guilhembn/IOBoard_2021/Readme.md

# IO board Eurobot 2021

## Protobuf

For the fist time you try to build protobuf files, you need to run `setups.sh` in EmbeddedProto:

`cd software/lib/EmbeddedProto`
`./setup.sh`
