guilhembn/IOBoard_2021/statuette/statuette.kicad_pcb

## KiCad design statuette/statuette.kicad_pcb (2022-02-09)

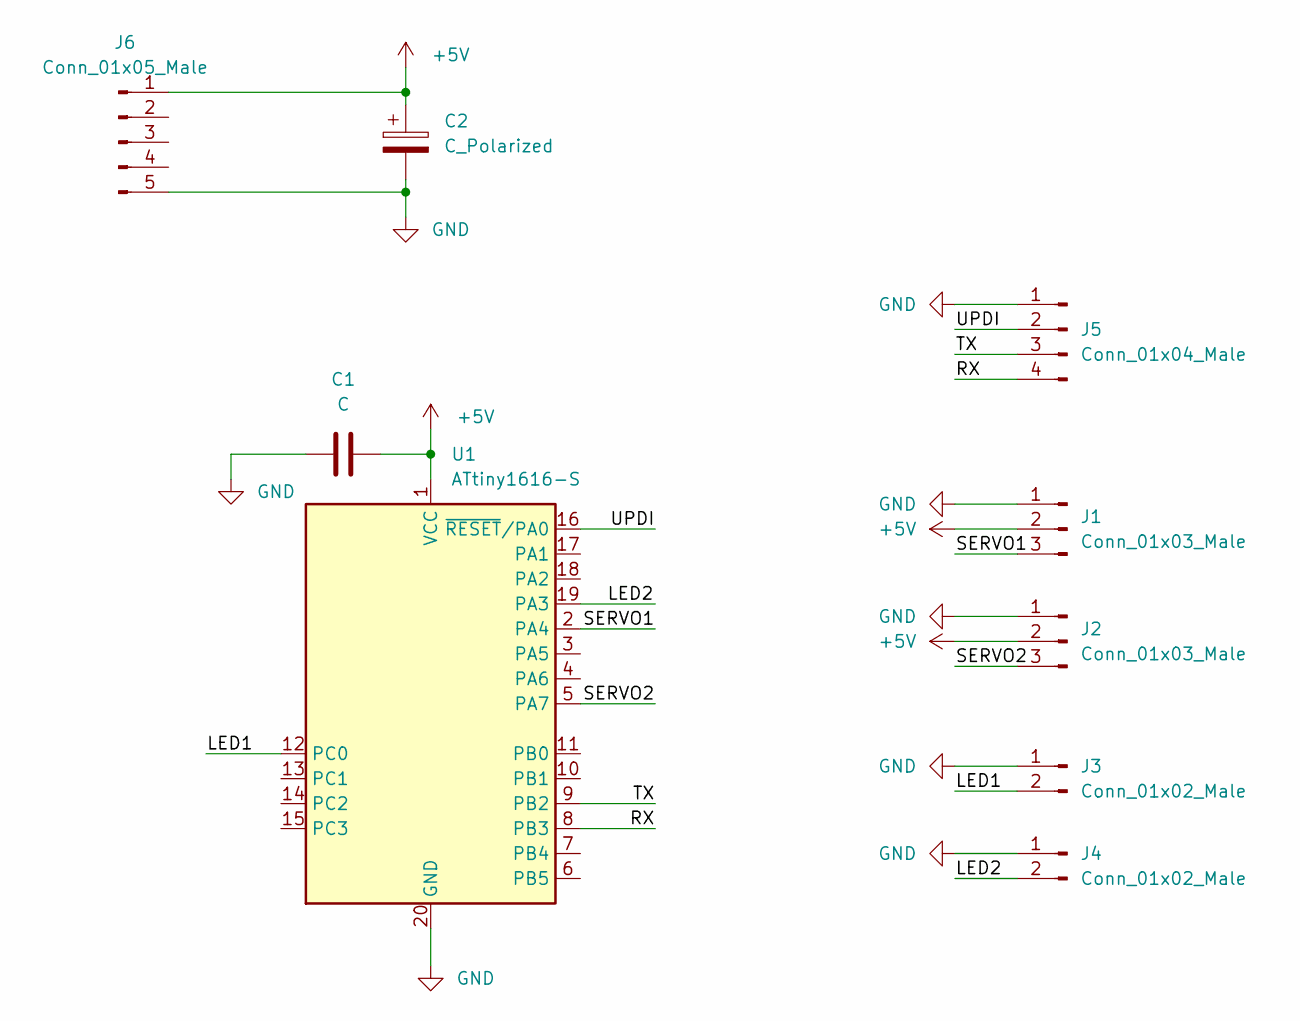
[picture p1: schematic statuette.kicad_sch]

Parts:
C1: C; C_0603_1608Metric_Pad1.08x0.95mm_HandSolder
C2: C_Polarized; CP_EIA-6032-28_Kemet-C_Pad2.25x2.35mm_HandSolder
J1, J2: Conn_01x03_Male; PinHeader_1x03_P2.54mm_Vertical
J3, J4: Conn_01x02_Male; PinHeader_1x02_P2.54mm_Vertical
J5: Conn_01x04_Male; Molex_PicoBlade_53047-0410_1x04_P1.25mm_Vertical
J6: Conn_01x05_Male; PinHeader_1x05_P2.54mm_Vertical
U1: ATtiny1616-S; SOIC-20W_7.5x12.8mm_P1.27mm

Connections:
+5V: C1.2, C2.1, J1.2, J2.2, J6.1, U1.1 (VCC)
/LED1: J3.2, U1.12 (PC0)
/LED2: J4.2, U1.19 (PA3)
/RX: J5.4, U1.8 (PB3)
/SERVO1: J1.3, U1.2 (PA4)
/SERVO2: J2.3, U1.5 (PA7)
/TX: J5.3, U1.9 (PB2)
/UPDI: J5.2, U1.16 (~RESET/PA0)
GND: C1.1, C2.2, J1.1, J2.1, J3.1, J4.1, J5.1, J6.5, U1.20 (GND)

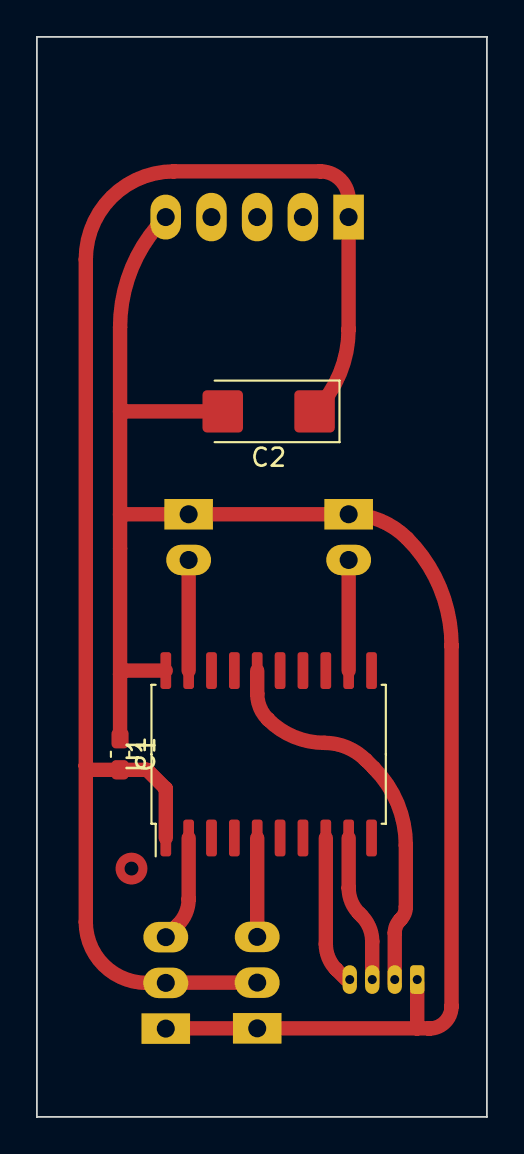
[picture p2: board statuette.kicad_pcb from above]

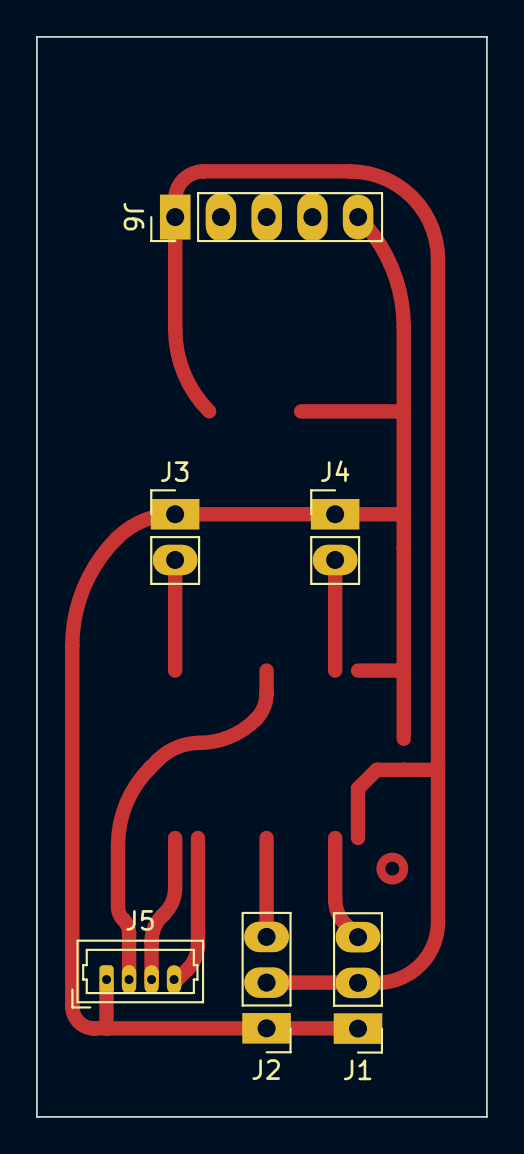
[picture p3: board statuette.kicad_pcb from below]

Board: 2 copper layers, 25.0 x 60.0 mm, 9 parts (6 on the bottom side), 9 nets.
