guilhembn/IOBoard_2021/hardware/IOBoard2021/IOBoard2021.kicad_pcb

## KiCad design hardware/IOBoard2021/IOBoard2021.kicad_pcb (2022-02-09)

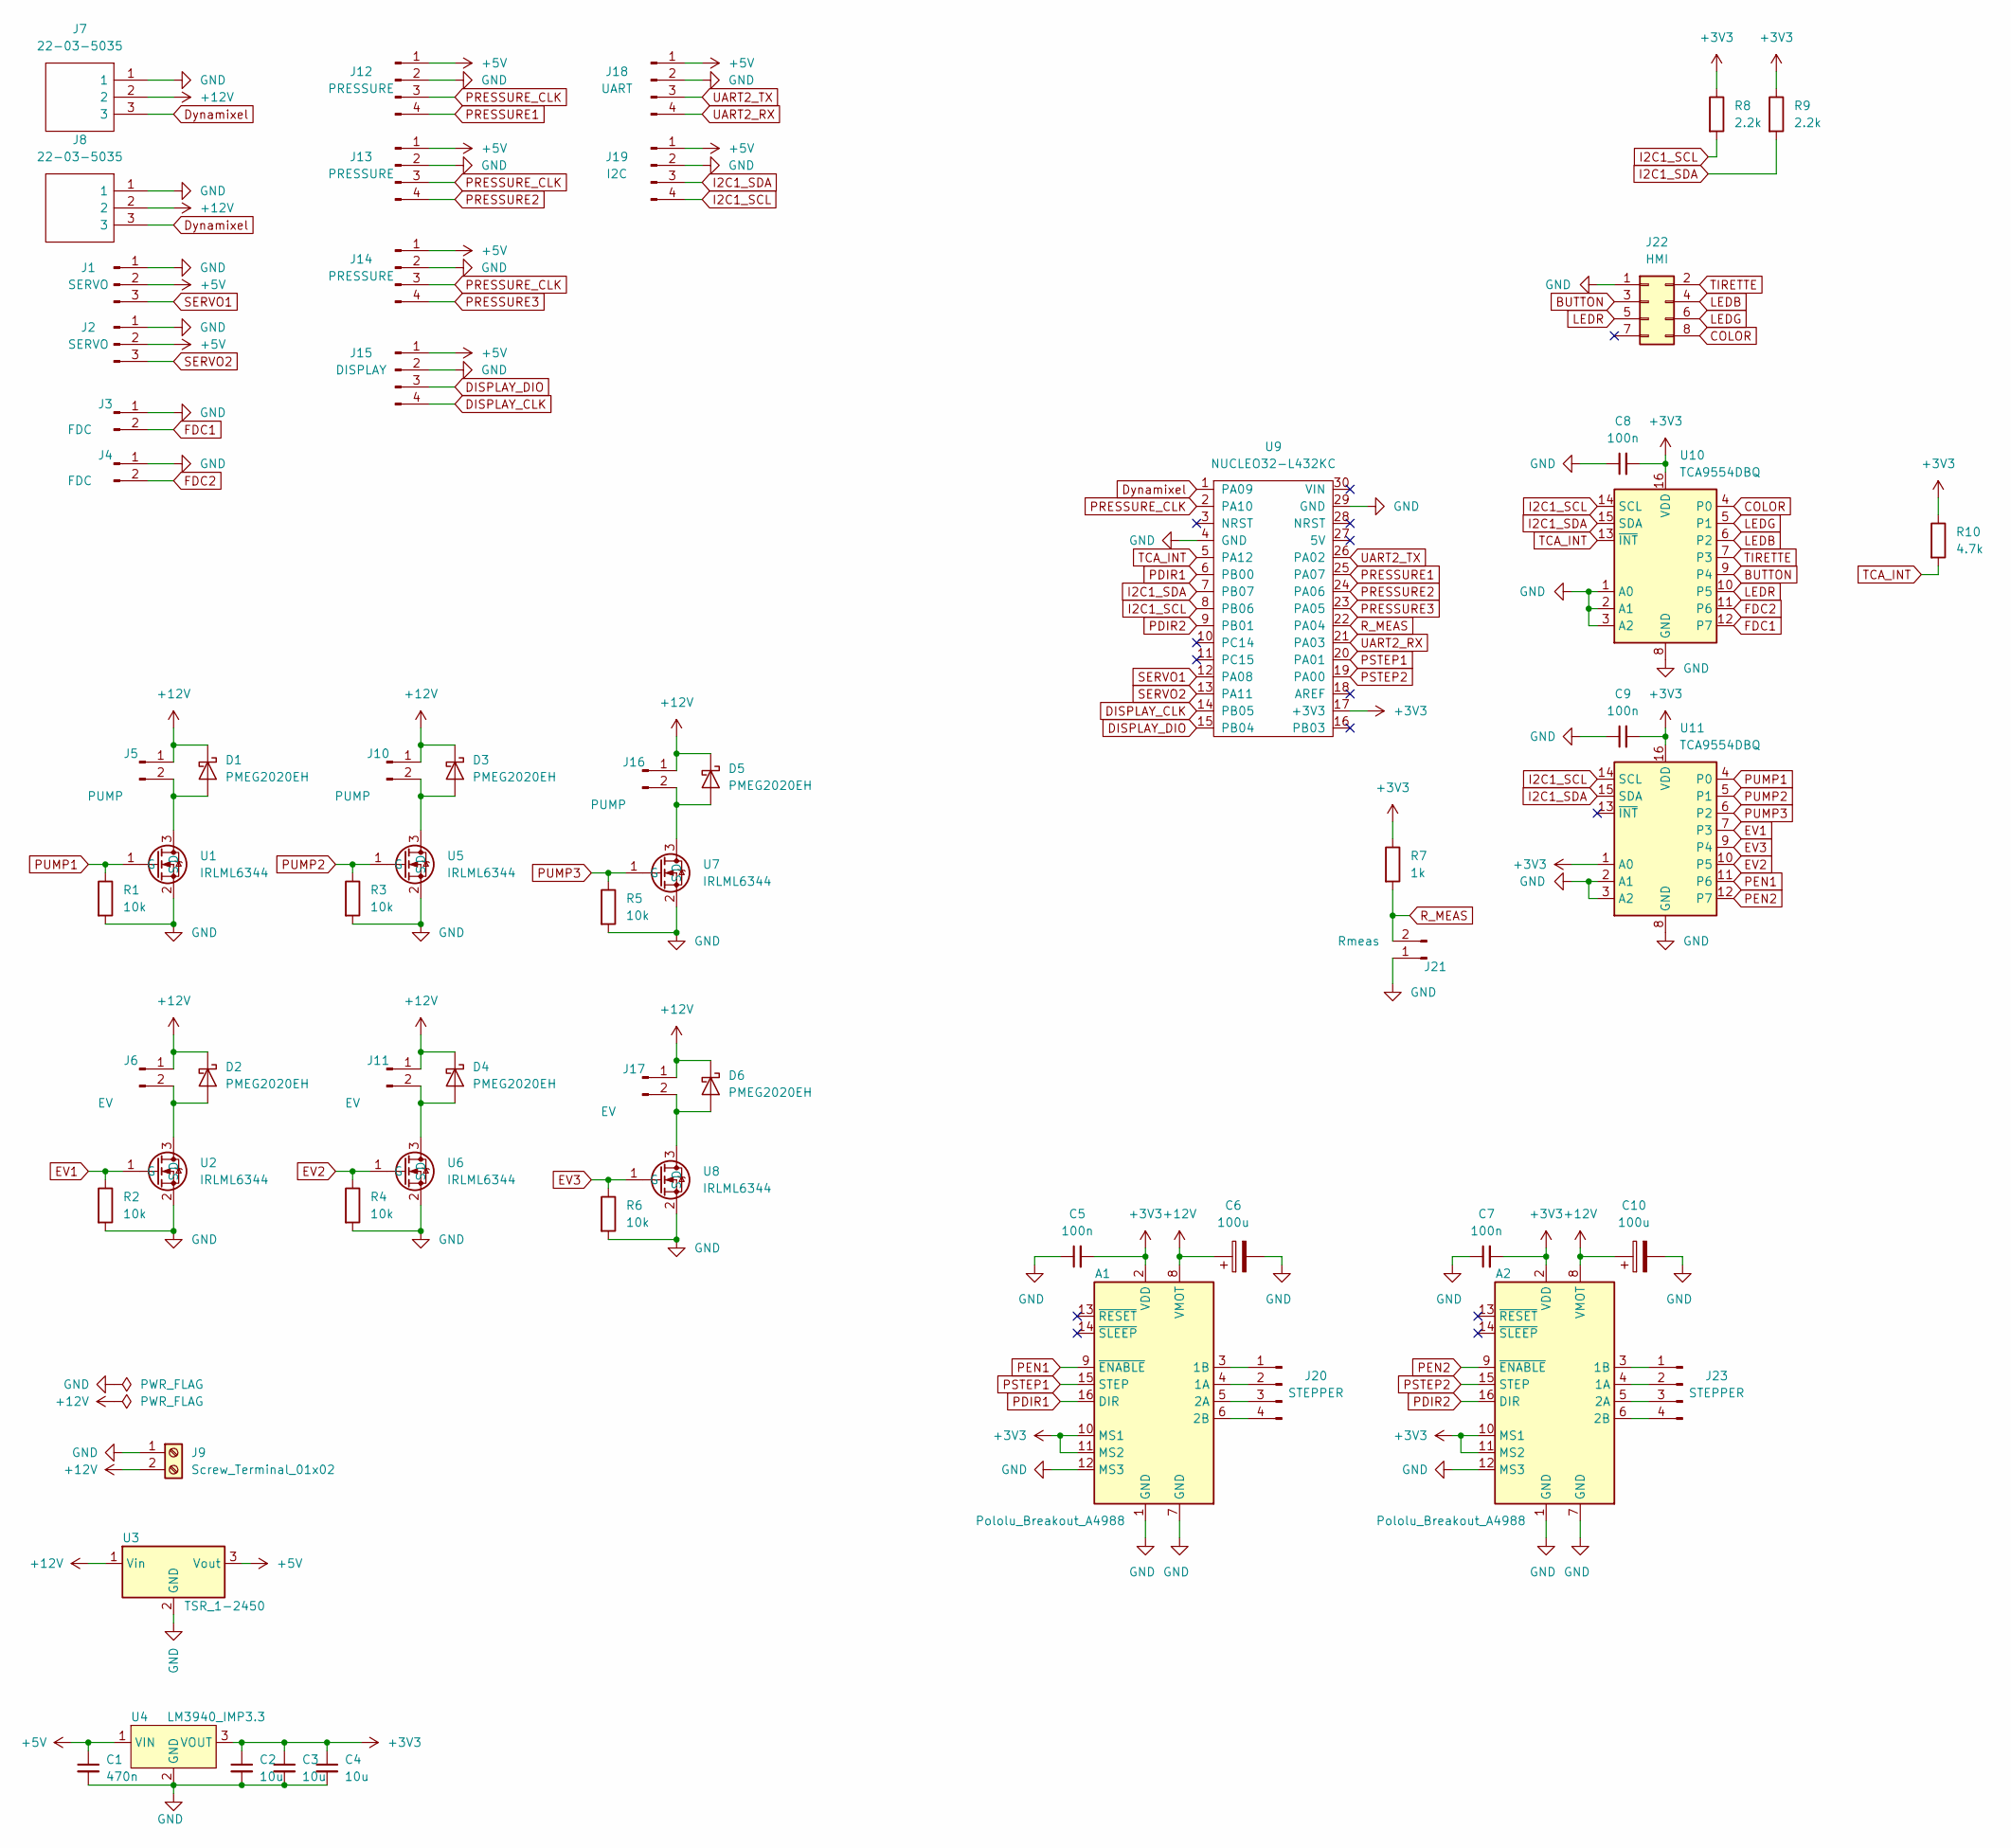
[picture p4: schematic IOBoard2021.kicad_sch, IO board 2022]

Parts:
A1, A2: Pololu_Breakout_A4988; Pololu_Breakout-16_15.2x20.3mm
C1: 470n; C_0603_1608Metric_Pad1.08x0.95mm_HandSolder
C2, C3, C4: 10u; C_0603_1608Metric_Pad1.08x0.95mm_HandSolder
C5, C7, C8, C9: 100n; C_0603_1608Metric_Pad1.08x0.95mm_HandSolder
C6, C10: 100u; CP_EIA-7343-31_Kemet-D_Pad2.25x2.55mm_HandSolder
D1, D2, D3, D4, D5, D6: PMEG2020EH; D_SOD-123F
J1, J2: SERVO; PinHeader_1x03_P2.54mm_Vertical
J3, J4: FDC; PinHeader_1x02_P2.54mm_Vertical
J5, J10, J16: PUMP; PinHeader_1x02_P2.54mm_Vertical_SMD_Pin1Left
J6, J11, J17: EV; PinHeader_1x02_P2.54mm_Vertical_SMD_Pin1Left
J7, J8: 22-03-5035; SHDR3W70P0X250_1X3_990X490X590P; Manufacturer_Part_Number 22-03-5035; Mouser Part Number 538-22-03-5035
J9: Screw_Terminal_01x02; TerminalBlock_bornier-2_P5.08mm
J12, J13, J14: PRESSURE; Molex_PicoBlade_53398-0471_1x04-1MP_P1.25mm_Vertical
J15: DISPLAY; Molex_PicoBlade_53398-0471_1x04-1MP_P1.25mm_Vertical
J18: UART; Molex_PicoBlade_53398-0471_1x04-1MP_P1.25mm_Vertical
J19: I2C; Molex_PicoBlade_53398-0471_1x04-1MP_P1.25mm_Vertical
J20, J23: STEPPER; PinHeader_1x04_P2.54mm_Vertical
J21: Rmeas; PinHeader_1x02_P2.54mm_Vertical
J22: HMI; IDC-Header_2x04_P2.54mm_Vertical
R1, R2, R3, R4, R5, R6: 10k; R_0603_1608Metric_Pad0.98x0.95mm_HandSolder
R7: 1k; R_0603_1608Metric_Pad0.98x0.95mm_HandSolder
R8, R9: 2.2k; R_0603_1608Metric_Pad0.98x0.95mm_HandSolder
R10: 4.7k; R_0603_1608Metric_Pad0.98x0.95mm_HandSolder
U1, U2, U5, U6, U7, U8: IRLML6344; SOT-23
U3: TSR_1-2450; Converter_DCDC_TRACO_TSR-1_THT
U4: LM3940_IMP3.3; SOT-223-3_TabPin2
U9: NUCLEO32-L432KC; NUCLEO32
U10, U11: TCA9554DBQ; SSOP-16_3.9x4.9mm_P0.635mm

Connections:
+3V3: A1.2 (VDD), A1.10 (MS1), A1.11 (MS2), A2.2 (VDD), A2.10 (MS1), A2.11 (MS2), C2.1, C3.1, C4.1, C5.2, C7.2, C8.2, C9.2, R7.1, R8.1, R9.1, R10.1, U4.3 (VOUT), U9.17 (+3V3), U10.16 (VDD), U11.1 (A0), U11.16 (VDD)
+5V: C1.1, J1.2, J2.2, J12.1, J13.1, J14.1, J15.1, J18.1, J19.1, U3.3 (Vout), U4.1 (VIN)
+12V: A1.8 (VMOT), A2.8 (VMOT), C6.1, C10.1, D1.1 (K), D2.1 (K), D3.1 (K), D4.1 (K), D5.1 (K), D6.1 (K), J5.1, J6.1, J7.2, J8.2, J9.2, J10.1, J11.1, J16.1, J17.1, U3.1 (Vin)
BUTTON: J22.3, U10.9 (P4)
COLOR: J22.8, U10.4 (P0)
DISPLAY_CLK: J15.4, U9.14 (PB05)
DISPLAY_DIO: J15.3, U9.15 (PB04)
Dynamixel: J7.3, J8.3, U9.1 (PA09)
EV1: R2.1, U2.1 (G), U11.7 (P3)
EV2: R4.1, U6.1 (G), U11.10 (P5)
EV3: R6.1, U8.1 (G), U11.9 (P4)
FDC1: J3.2, U10.12 (P7)
FDC2: J4.2, U10.11 (P6)
GND: A1.1 (GND), A1.7 (GND), A1.12 (MS3), A2.1 (GND), A2.7 (GND), A2.12 (MS3), C1.2, C2.2, C3.2, C4.2, C5.1, C6.2, C7.1, C8.1, C9.1, C10.2, J1.1, J2.1, J3.1, J4.1, J7.1, J8.1, J9.1, J12.2, J13.2, J14.2, J15.2, J18.2, J19.2, J21.1, J22.1, R1.2, R2.2, R3.2, R4.2, R5.2, R6.2, U1.2 (S), U2.2 (S), U3.2 (GND), U4.2 (GND), U5.2 (S), U6.2 (S), U7.2 (S), U8.2 (S), U9.4 (GND), U9.29 (GND), U10.1 (A0), U10.2 (A1), U10.3 (A2), U10.8 (GND), U11.2 (A1), U11.3 (A2), U11.8 (GND)
I2C1_SCL: J19.4, R8.2, U9.8 (PB06), U10.14 (SCL), U11.14 (SCL)
I2C1_SDA: J19.3, R9.2, U9.7 (PB07), U10.15 (SDA), U11.15 (SDA)
LEDB: J22.4, U10.6 (P2)
LEDG: J22.6, U10.5 (P1)
LEDR: J22.5, U10.10 (P5)
unnamed: A1.3 (1B), J20.1
unnamed: A1.4 (1A), J20.2
unnamed: A1.5 (2A), J20.3
unnamed: A1.6 (2B), J20.4
unnamed: A2.3 (1B), J23.1
unnamed: A2.4 (1A), J23.2
unnamed: A2.5 (2A), J23.3
unnamed: A2.6 (2B), J23.4
unnamed: D1.2 (A), J5.2, U1.3 (D)
unnamed: D2.2 (A), J6.2, U2.3 (D)
unnamed: D3.2 (A), J10.2, U5.3 (D)
unnamed: D4.2 (A), J11.2, U6.3 (D)
unnamed: D5.2 (A), J16.2, U7.3 (D)
unnamed: D6.2 (A), J17.2, U8.3 (D)
PDIR1: A1.16 (DIR), U9.6 (PB00)
PDIR2: A2.16 (DIR), U9.9 (PB01)
PEN1: A1.9 (~ENABLE), U11.11 (P6)
PEN2: A2.9 (~ENABLE), U11.12 (P7)
PRESSURE1: J12.4, U9.25 (PA07)
PRESSURE2: J13.4, U9.24 (PA06)
PRESSURE3: J14.4, U9.23 (PA05)
PRESSURE_CLK: J12.3, J13.3, J14.3, U9.2 (PA10)
PSTEP1: A1.15 (STEP), U9.20 (PA01)
PSTEP2: A2.15 (STEP), U9.19 (PA00)
PUMP1: R1.1, U1.1 (G), U11.4 (P0)
PUMP2: R3.1, U5.1 (G), U11.5 (P1)
PUMP3: R5.1, U7.1 (G), U11.6 (P2)
R_MEAS: J21.2, R7.2, U9.22 (PA04)
SERVO1: J1.3, U9.12 (PA08)
SERVO2: J2.3, U9.13 (PA11)
TCA_INT: R10.2, U9.5 (PA12), U10.13 (~INT)
TIRETTE: J22.2, U10.7 (P3)
UART2_RX: J18.4, U9.21 (PA03)
UART2_TX: J18.3, U9.26 (PA02)

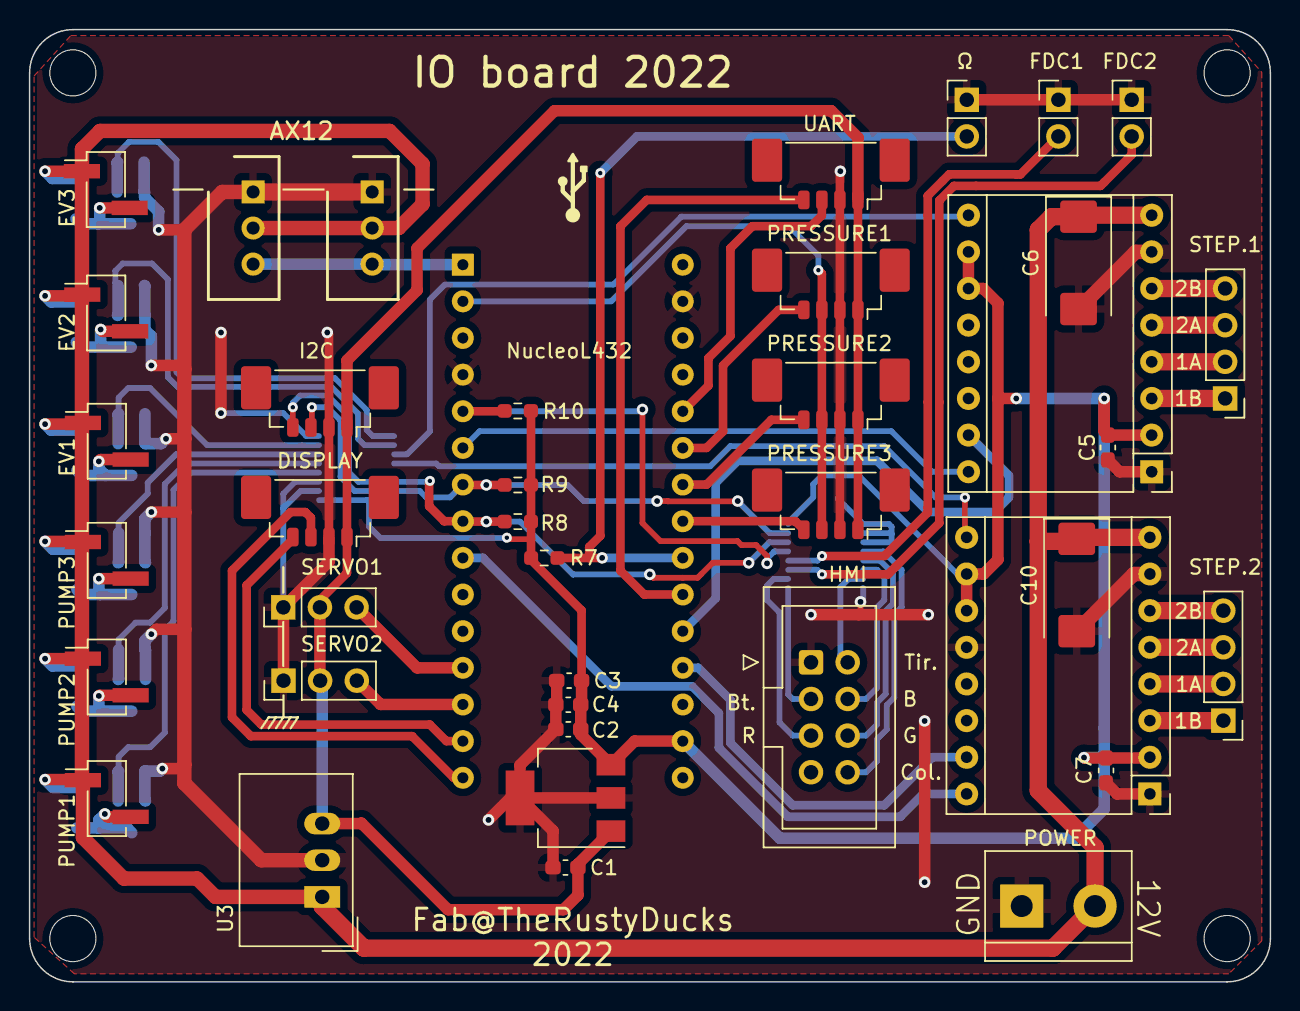
[picture p5: board IOBoard2021.kicad_pcb from above]

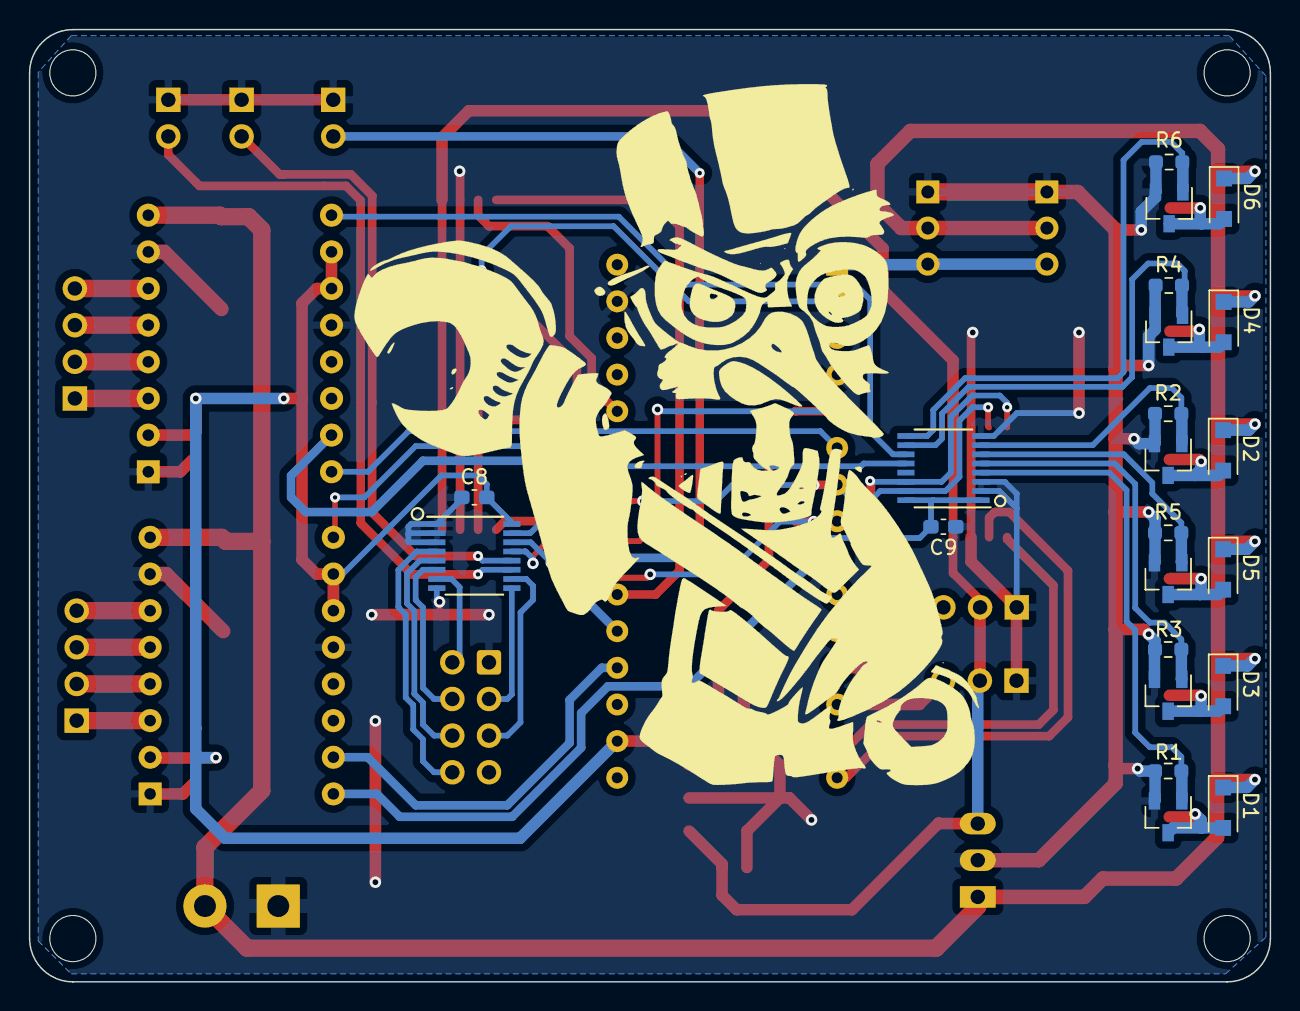
[picture p6: board IOBoard2021.kicad_pcb from below]

Board: 2 copper layers, 86.0 x 66.0 mm, 62 parts (22 on the bottom side), 53 nets.
