guilhembn/IOBoard_2021/software/src/ducklink/Communication.cpp

#include "ducklink/Communication.h"
#include "procedures/ProcedureManager.h"
#include "Arm.h"
#include "Hat.h"

Communication communication(&Serial2);

Communication::Communication(HardwareSerial* serial) : receiveState_(Communication::eRcvState::START_1), serial_(serial) {}

void Communication::init(int baudrate) { serial_->begin(baudrate); }

Communication::eMessageStatus Communication::checkMessages(Message& msg) {
    msg.clear();
    uint8_t byte;
    size_t readLen;
    if (receiveState_ == Communication::eRcvState::START_1) {
        rcvBuffer_.clear();
        checksum_ = 0;
        if (serial_->available()) {
            readLen = serial_->readBytes(&byte, 1);
            if (readLen == 1 && byte == 0xFF) {
                receiveState_ = Communication::eRcvState::START_2;
            }
        }
    }
    if (receiveState_ == Communication::eRcvState::START_2) {
        if (serial_->available()) {
            readLen = serial_->readBytes(&byte, 1);
            if (readLen == 1) {
                if (byte == 0xFF) {
                    receiveState_ = Communication::eRcvState::LEN;
                } else {
                    receiveState_ = Communication::eRcvState::START_1;
                }
            }
        }
    }
    if (receiveState_ == Communication::eRcvState::LEN) {
        if (serial_->available()) {
            readLen = serial_->readBytes(&byte, 1);
            if (readLen == 1) {
                nbBytesExpected_ = byte;
                receiveState_ = Communication::eRcvState::PAYLOAD;
            }
        }
    }
    if (receiveState_ == Communication::eRcvState::PAYLOAD) {
        if (serial_->available() >= nbBytesExpected_) {
            for (size_t i = 0; i < nbBytesExpected_; i++) {
                serial_->readBytes(&byte, 1);
                checksum_ ^= byte;
                rcvBuffer_.push(byte);
            }
            receiveState_ = Communication::eRcvState::CHECKSUM;
        }
    }
    if (receiveState_ == Communication::eRcvState::CHECKSUM) {
        if (serial_->available()) {
            readLen = serial_->readBytes(&byte, 1);
            if (readLen == 1) {
                receiveState_ = Communication::eRcvState::START_1;
                if (byte == checksum_) {
                    EmbeddedProto::Error err = msg.deserialize(rcvBuffer_);
                    if (err == EmbeddedProto::Error::NO_ERRORS) {
                        return Communication::eMessageStatus::NEW_MSG;
                    } else {
                        return Communication::eMessageStatus::COM_ERROR;
                    }
                } else {
                    return Communication::eMessageStatus::COM_ERROR;
                }
            }
        }
    }
    return Communication::eMessageStatus::NO_MSG;
}

void Communication::sendArmStatus(Arm& arm) {
    Message msg;
    protoduck::Arm& armStatus = msg.mutable_arm();

    float zPriPosition = arm.getPosition(Arm::eJoint::PRISMATIC_Z);
    float zRotPosition = arm.getPosition(Arm::eJoint::REVOLUTE_Z);
    float yRotPosition = arm.getPosition(Arm::eJoint::REVOLUTE_Y);
    bool pumpEnabled = arm.isPumpStarted();
    bool valveClosed = arm.isValveOpen();
    auto pressureValue = arm.pressure();

    armStatus.set_arm_id(arm.getId());
    armStatus.set_traZ(zPriPosition);
    armStatus.set_rotZ(zRotPosition);
    armStatus.set_rotY(yRotPosition);
    armStatus.set_pump(pumpEnabled);
    armStatus.set_valve(valveClosed);
    armStatus.set_pressure(pressureValue);
    send(msg);
}

void Communication::sendHatStatus(Hat& hat) {
    Message msg;
    protoduck::Hat& hatStatus = msg.mutable_hat();
    hatStatus.set_height(hat.getHeight());
    hatStatus.set_pump(hat.isPumpStarted());
    hatStatus.set_valve(hat.isValveOpen());
    hatStatus.set_pressure(hat.pressure());
    send(msg);
}

void Communication::sendProcedureStatus(ProcedureManager& pm) {
    Message msg;
    msg.set_msg_type(Message::MsgType::STATUS);
    auto& procedure = msg.mutable_procedure();
    procedure.set_status(pm.getStatus());
    auto p = pm.getParams();
    procedure.set_arm_id(p.arm_id);
    procedure.set_param(p.param);
    procedure.set_proc(p.proc);
    
    send(msg);
}

void Communication::sendError(::protoduck::Error::Errors e, uint32_t param) {
    Message msg;
    msg.set_msg_type(Message::MsgType::STATUS);
    auto& error = msg.mutable_error();
    error.set_error(e);
    error.set_param(param);
    send(msg);
}

void Communication::sendHMI() {
    Message msg;
    msg.set_msg_type(Message::MsgType::STATUS);
    auto& hmi = msg.mutable_hmi();
    hmi.set_bouton(!gpios.read(Gpios::Signal::BUTTON));
    hmi.set_color(gpios.read(Gpios::Signal::COLOR));
    hmi.set_tirette(gpios.read(Gpios::Signal::TIRETTE));
    // led and display not set.
    send(msg);
}

void Communication::send(Message msg) {
    msg.set_source(Message::Agent::DIFF);
    msg.set_msg_type(Message::MsgType::STATUS);
    BytesWriteBuffer sendBuffer;
    sendBuffer.clear();
    msg.serialize(sendBuffer);
    uint8_t header[] = {0xFF, 0xFF, 0};
    header[2] = sendBuffer.get_size();
    uint8_t* data = sendBuffer.get_data();
    uint8_t checksum = 0;
    for (size_t i = 0; i < sendBuffer.get_size(); i++) {
        checksum ^= data[i];
    }
    serial_->write(header, 3);
    serial_->write(data, sendBuffer.get_size());
    serial_->write(&checksum, 1);
}
