guilhembn/IOBoard_2021/software/src/procedures/procedure_home.cpp

#include "procedure_home.h"
#include "Arm.h"
#include "Arduino.h"

ProcHome proc_home;

ProcedureState ProcHome::loop() {
    if(current_state == State::INITIAL_DOWN) {
        if(arm->zStopStatus() == HIGH) {
            time_zstop_released = millis();
            current_state = State::WAIT;
            setTimeout(2000);
        }
    }

    if(current_state == State::WAIT) {
        if(millis() - time_zstop_released > 500) {
            arm->zAxisStepper_.setTargetRel(10000);
            arm->controller.moveAsync(arm->zAxisStepper_);
            current_state = State::UP;
            setTimeout(10000);
        }
    }

    if(current_state == State::UP) {
        if(arm->zStopStatus() == LOW) {
            arm->zAxisStepper_.setMaxSpeed(STEPPER_MAX_SPEED);
            arm->zAxisStepper_.setPosition(5*STEP_PER_MM);
            arm->zAxisStepper_.setTargetAbs(0);  // go down 5mm to release stop switch
            arm->controller.move(arm->zAxisStepper_);
            current_state = State::DOWN_FINAL;
            setTimeout(2000);
        }
    }

    if(current_state == State::DOWN_FINAL) {
        auto pos = arm->zAxisStepper_.getPosition();
        if(abs(pos) < STEP_PER_MM) {
            arm->rotateIdle();
            status = protoduck::Procedure::Status::SUCCESS;
            return ProcedureState::IDLE;
        }

    }

    return ProcedureState::RUNNING;
}

ProcedureState ProcHome::reset() {
    arm->enableZMotor(true);
    arm->zAxisStepper_.setPosition(0);
    arm->zAxisStepper_.setMaxSpeed(STEPPER_HOME_SPEED);     // slow
    time_zstop_released = 0;
    if(arm->zStopStatus()) {
        current_state = UP;
        arm->zAxisStepper_.setTargetAbs(10000);
        setTimeout(10000);
    } else {
        current_state = INITIAL_DOWN;
        arm->zAxisStepper_.setTargetAbs(-10000);
        setTimeout(2000);
    }
    
    arm->controller.moveAsync(arm->zAxisStepper_);

    arm->sendPositionCommand(Arm::eJoint::REVOLUTE_Z, 820);
    arm->sendPositionCommand(Arm::eJoint::REVOLUTE_Y, 512);

    status = protoduck::Procedure::Status::RUNNING_FREE;
    return ProcedureState::RUNNING;
}
