guilhembn/IOBoard_2021/software/src/ducklink/BytesReadBuffer.cpp

/*
 *  Copyright (C) 2020 Embedded AMS B.V. - All Rights Reserved
 *
 *  This file is part of Embedded Proto.
 *
 *  Embedded Proto is open source software: you can redistribute it and/or
 *  modify it under the terms of the GNU General Public License as published
 *  by the Free Software Foundation, version 3 of the license.
 *
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
 *  For commercial and closed source application please visit:
 *  <https://EmbeddedProto.com/license/>.
 *
 *  Embedded AMS B.V.
 *  Info:
 *    info at EmbeddedProto dot com
 *
 *  Postal adress:
 *    Johan Huizingalaan 763a
 *    1066 VH, Amsterdam
 *    the Netherlands
 */

#include "ducklink/BytesReadBuffer.h"

BytesReadBuffer::BytesReadBuffer() : data_{0}, write_index_(0), read_index_(0) {}

uint32_t BytesReadBuffer::get_size() const { return write_index_; }

uint32_t BytesReadBuffer::get_max_size() const { return MAX_SIZE; }

bool BytesReadBuffer::peek(uint8_t& byte) const {
    bool return_value = write_index_ > read_index_;
    if (return_value) {
        byte = data_[read_index_];
    }
    return return_value;
}

void BytesReadBuffer::advance() { ++read_index_; }

void BytesReadBuffer::advance(const uint32_t N) { read_index_ += N; }

bool BytesReadBuffer::pop(uint8_t& byte) {
    bool return_value = write_index_ > read_index_;
    if (return_value) {
        byte = data_[read_index_];
        ++read_index_;
    }
    return return_value;
}

uint8_t* BytesReadBuffer::get_data_array() { return data_; }

uint32_t& BytesReadBuffer::get_bytes_written() { return write_index_; }

void BytesReadBuffer::clear() {
    read_index_ = 0;
    write_index_ = 0;
}

bool BytesReadBuffer::push(uint8_t& byte) {
    bool return_value = MAX_SIZE > write_index_;
    if (return_value) {
        data_[write_index_] = byte;
        ++write_index_;
    }
    return return_value;
}
