guilhembn/IOBoard_2021/(commit log)

2021-11-21 Improves interfaces to Arm, Hat and Vacuum System
2021-11-21 Updates platformio.ini to flash the IO board
2021-12-15 Use TeensyStep instead of AccelStep.
2021-12-15 Automatically disable steppers after timeout.
2021-12-23 Start elec
    [IOBoard2021.kicad_pcb, IOBoard2021.kicad_sch]
2022-02-01 Finish schematic and copper layout.
    [IOBoard2021.kicad_pcb, IOBoard2021.kicad_sch]
2022-02-01 Finish board.
    [IOBoard2021.kicad_pcb, IOBoard2021.kicad_sch]
2022-02-01 Add schematic PDF.
2022-02-09 Add statuette elec.
    [statuette.kicad_pcb, statuette.kicad_sch]
2022-02-12 Adapt to new board.
2022-02-12 Add driver for pressure readings.
2022-03-29 Add procedure Unstack, and fix various bugs.
    [Arm.h, ProcedureManager.cpp, ProcedureManager.h, main.cpp, procedure_home.cpp, procedure_home.h, procedure_stack.cpp, procedure_stack.h]
2022-04-26 Enable UART RX pin.
2022-05-24 Disable stepper timeout
2022-05-24 Open valve when starting pump.
